shimotoriharuki/reRo_robotrace_board_public/README.md

# reRo_robotrace_board_public
This is the code and circuit for UnderBird_3.x.

The author of the schematic in the circuit directory is [IGC8810](https://github.com/IGC8810).

The author of the codes in the main_code directory and analysis_code directory is [Haruki SHIMOTORI](https://github.com/shimotoriharuki).

(https://www.youtube.com/watch?v=qso0mbpABHY)

# Environment
CubeIDE 1.11.2

# LICENSE
This repository is released under the BSD 3-Clause license.

© Haruki SHIMOTORI and IGC8810
