shimotoriharuki/reRo_robotrace_board_public/(threads)

Thread 1 (2025-08-12):

オープンソースライセンス誤用に関するお詫びと説明

X2002w, 2025-08-12:
i7 先輩

拝啓

個人開発者のXW2002（https://gitee.com/WL2002）と申します。まず、先輩が惜しみなく共有してくださった技術成果に心より感謝申し上げます。2023年に公開されたRoboTracer吸引式負圧に関する技術記事（https://underbirdworks.blogspot.com/2023/12/2023-underbird3x.html）は、私に多大な啓発と助けをくださいました。

このたび、私はGiteeにおいて自分が探求した吸引式負圧に関する技術経験のまとめを公開しましたが、その中で先輩のオープンソースコンテンツを参考にさせていただきました。しかし公開時に重大な過失を犯してしまいました。正しくはCC BY-SA 4.0を使用すべきところ、誤って別のライセンスを選択してしまったのです。

**問題に気付き次第、以下の是正措置を講じました。**

ライセンスをCC BY-SA 4.0に修正しました。
READMEファイルに先輩のオリジナルの貢献および技術記事のリンクを明記しました。
Giteeのコミット記録に今回の修正を特別に記載しました。

今回の失敗により先輩にご迷惑をおかけしたかもしれないこと、心よりお詫び申し上げます。先輩の技術共有は私にとって非常に大きな助けとなり、その上で私は吸引式負圧システムの開発をさらに進めることができました。また、この経験を通じて、オープンソース精神の尊さを深く実感しました。今回のオープンソースライセンスに関する不注意について、どうかご寛容いただけますようお願い申し上げます。もし他に修正や調整が必要な点がございましたら、どうぞご遠慮なくお知らせください。速やかに対応させていただきます。

shimotoriharuki, 2025-08-12:
Thank you for getting in touch. There is no problem. I appreciate your sincere response.
