shimotoriharuki/reRo_robotrace_board_public/main_code/Core/Src/main.c

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
/* Includes ------------------------------------------------------------------*/
#include "main.h"
#include "fatfs.h"

/* USER CODE BEGIN Includes */
//#include "AQM0802.h"
#include "stdio.h"
//#include "MPU6500.h"
#include "cppMain.hpp"

/* USER CODE END Includes */

ADC_HandleTypeDef hadc1;
DMA_HandleTypeDef hdma_adc1;

SD_HandleTypeDef hsd;
DMA_HandleTypeDef hdma_sdio_rx;
DMA_HandleTypeDef hdma_sdio_tx;

SPI_HandleTypeDef hspi2;
SPI_HandleTypeDef hspi3;

TIM_HandleTypeDef htim1;
TIM_HandleTypeDef htim2;
TIM_HandleTypeDef htim3;
TIM_HandleTypeDef htim4;
TIM_HandleTypeDef htim6;
TIM_HandleTypeDef htim7;
TIM_HandleTypeDef htim8;
TIM_HandleTypeDef htim10;

/* USER CODE BEGIN PV */
uint16_t tim6_timer;
uint16_t tim7_timer;
uint16_t tim10_timer;


/* USER CODE END PV */

void SystemClock_Config(void);
static void MX_GPIO_Init(void);
static void MX_DMA_Init(void);
static void MX_ADC1_Init(void);
static void MX_SDIO_SD_Init(void);
static void MX_SPI2_Init(void);
static void MX_TIM1_Init(void);
static void MX_TIM8_Init(void);
static void MX_TIM6_Init(void);
static void MX_TIM2_Init(void);
static void MX_TIM7_Init(void);
static void MX_SPI3_Init(void);
static void MX_TIM4_Init(void);
static void MX_TIM10_Init(void);
static void MX_TIM3_Init(void);
/* USER CODE BEGIN 0 */
int _write(int file, char *ptr, int len)
{
	int DataIdx;
	for(DataIdx=0; DataIdx<len; DataIdx++)
	{
		ITM_SendChar(*ptr++);
	}
	return len;
}


void HAL_GPIO_EXTI_Callback(uint16_t GPIO_Pin)
{
	cppExit(GPIO_Pin);
}


void HAL_TIM_PeriodElapsedCallback(TIM_HandleTypeDef *htim)
{
	if(htim->Instance == TIM7){		//0.1ms
		cppFlip100ns();

		tim7_timer++;
		if(tim7_timer >= 100000) tim7_timer = 0;
	}

	if (htim->Instance == TIM6){	//1msec
		cppFlip1ms();

		tim6_timer++;
		if(tim6_timer >= 100000) tim6_timer = 0;
	}

	if (htim->Instance == TIM10){	//10msec
		cppFlip10ms();

		tim10_timer++;
		if(tim10_timer >= 100000) tim10_timer = 0;
	}

}

/* USER CODE END 0 */

/**
  * @brief  The application entry point.
  * @retval int
  */
int main(void)
{
  /* MCU Configuration--------------------------------------------------------*/

  /* Reset of all peripherals, Initializes the Flash interface and the Systick. */
  HAL_Init();

  /* Configure the system clock */
  SystemClock_Config();

  /* Initialize all configured peripherals */
  MX_GPIO_Init();
  MX_DMA_Init();
  MX_ADC1_Init();
  MX_SDIO_SD_Init();
  MX_SPI2_Init();
  MX_TIM1_Init();
  MX_TIM8_Init();
  MX_TIM6_Init();
  MX_FATFS_Init();
  MX_TIM2_Init();
  MX_TIM7_Init();
  MX_SPI3_Init();
  MX_TIM4_Init();
  MX_TIM10_Init();
  MX_TIM3_Init();
  /* USER CODE BEGIN 2 */
	cppInit();


	//printf("HelloWorld!!\r\n");


  /* USER CODE END 2 */

  /* Infinite loop */
  /* USER CODE BEGIN WHILE */
	while (1)
	{
		cppLoop();

    /* USER CODE END WHILE */

    /* USER CODE BEGIN 3 */
	}
  /* USER CODE END 3 */
}

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
