shimotoriharuki/reRo_robotrace_board_public/main_code/reRo_robotrace_board_code.ioc

Mcu.UserName=STM32F446RETx
PA0-WKUP.Signal=ADCx_IN0
PA1.Signal=ADCx_IN1
PA10.Signal=S_TIM1_CH3
PA11.Signal=S_TIM1_CH4
PA12.Signal=GPIO_Input
PA13.Signal=SYS_JTMS-SWDIO
PA14.Signal=SYS_JTCK-SWCLK
PA15.Signal=GPIO_Output
PA2.Signal=ADCx_IN2
PA3.Signal=ADCx_IN3
PA4.Signal=ADCx_IN4
PA5.Signal=ADCx_IN5
PA6.Signal=ADCx_IN6
PA7.Signal=ADCx_IN7
PA8.Signal=S_TIM1_CH1
PA9.Signal=S_TIM1_CH2
PB0.Signal=S_TIM3_CH3
PB1.Signal=S_TIM3_CH4
PB12.Signal=GPIO_Output
PB13.Signal=SPI2_SCK
PB14.Signal=SPI2_MISO
PB15.Signal=SPI2_MOSI
PB3.Signal=SYS_JTDO-SWO
PB4.Signal=GPIO_Output
PB5.Signal=SPI3_MOSI
PB6.Signal=S_TIM4_CH1
PB7.Signal=S_TIM4_CH2
PB8.Signal=S_TIM2_CH1_ETR
PB9.Signal=S_TIM2_CH2
PC0.Signal=ADCx_IN10
PC1.Signal=ADCx_IN11
PC10.Signal=SPI3_SCK
PC11.Signal=GPIO_Input
PC12.Signal=SDIO_CK
PC13.Signal=GPXTI13
PC14-OSC32_IN.Signal=GPXTI14
PC15-OSC32_OUT.Signal=GPIO_Output
PC2.Signal=ADCx_IN12
PC3.Signal=ADCx_IN13
PC4.Signal=ADCx_IN14
PC5.Signal=GPIO_Output
PC6.Signal=S_TIM8_CH1
PC7.Signal=S_TIM8_CH2
PC8.Signal=SDIO_D0
PC9.Signal=GPIO_Input
PD2.Signal=SDIO_CMD
PH0-OSC_IN.Signal=RCC_OSC_IN
PH1-OSC_OUT.Signal=RCC_OSC_OUT
