shimotoriharuki/reRo_robotrace_board_public/main_code/Core/Src/sdCard.cpp

/*
 * sdCard.cpp
 *
 *  Created on: Jun 22, 2023
 *      Author: SHIMOTORI Haruki
 */

#include "sdCard.hpp"
#include "AQM0802.h"
#include <stdio.h>
#include "string.h"
#include <iostream>

void sdCard::openFile(const char *p_directory_name, const char *p_file_name)
{
	static int num;
	sprintf(dirpath_, "%s", p_directory_name);
	sprintf(filepath_, "%s", p_file_name);
	num++;

	f_mkdir(dirpath_);
	f_chdir(dirpath_);
	f_open(&fil_, filepath_, FA_OPEN_EXISTING| FA_READ | FA_WRITE);
	f_chdir("..");
}

void sdCard::clearBuff()
{
	for(int i = 0; i < BUFF_SIZE; i++){
		buffer_[i] = '\0';
	}
}

sdCard::sdCard() : buffer_{0}, filepath_{0}, dirpath_{0}{}

bool sdCard::init()
{
	if(mount() == 1){
		return true;

	}
	else{
		return false;
	}

}


bool sdCard::mount()
{
	bool ret = false;

	if(f_mount(&fs_, "", 1) == FR_OK) ret = true;
	else ret = false;

	return ret;
}

bool sdCard::unmout()
{
	bool ret = false;

	if(f_mount(NULL, "", 1) == FR_OK) ret = true;
	else ret = false;

	return ret;

}
void sdCard::userFopen(const char *p_directory_name, const char *p_file_name)
{
	openFile(p_directory_name, p_file_name);
}
void sdCard::userFclose()
{
	f_close(&fil_);	//ファイル閉じる
}
void sdCard::write(const char *p_directory_name, const char *p_file_name, uint16_t size, float *data)
{
	FRESULT res;

	// Change directory
	sprintf(dirpath_, "%s", p_directory_name);
	f_mkdir(dirpath_);
	f_chdir(dirpath_);

	// Initialize hidden file path for the serial number of filename
	char hidden_file_path[32];
	sprintf(hidden_file_path, "%c%s", '.', p_file_name);
	res = f_open(&fil_, hidden_file_path, FA_CREATE_NEW | FA_READ | FA_WRITE);
	if(res != FR_EXIST){ // If there is not the hidden file
		snprintf(buffer_, BUFF_SIZE, "%d", 0);
		f_lseek(&fil_, f_size(&fil_));	//	ファイルの最後に移動
		f_write(&fil_, buffer_, strlen(buffer_), &bw_);	//	書き込む
		f_close(&fil_);	//	ファイル閉じる

		f_chmod(hidden_file_path, AM_HID, AM_HID); // Set as hidden file

		clearBuff();	//	書き込み用のバッファをクリア
	}

	// ------Create file path----------//
	// Copy file name
	char file_name[32] = {'\0'};
	sprintf(file_name, "%s", p_file_name);

	// Get serial number
	char char_number[5] = {'\0'};
	res = f_open(&fil_, hidden_file_path, FA_OPEN_ALWAYS | FA_READ | FA_WRITE);
	f_gets(char_number, sizeof(char_number), &fil_);
	f_close(&fil_);	//	ファイル閉じる

	// Linkng
	char extension[5] = {'.', 't', 'x', 't', '\0'};
	sprintf(filepath_, "%s%s%s", file_name, char_number, extension);


	int int_number = 0;
	sscanf(char_number, "%d", &int_number);

	res = f_open(&fil_, filepath_, FA_CREATE_NEW | FA_READ | FA_WRITE);
	//if(res == FR_EXIST){ // If there is same file
	while(res == FR_EXIST){ // While there is same file
		int_number++;
		if(int_number >= 99999) int_number = 99999;

		sprintf(char_number, "%d", int_number);
		sprintf(filepath_, "%s%s%s", file_name, char_number, extension);
		res = f_open(&fil_, filepath_, FA_CREATE_NEW | FA_READ | FA_WRITE);
	}
	for(short i = 0 ; i < size; i++){
		snprintf(buffer_, BUFF_SIZE, "%f\n", *(data + i));	//floatをstringに変換

		f_lseek(&fil_, f_size(&fil_));	//	ファイルの最後に移動
		f_write(&fil_, buffer_, strlen(buffer_), &bw_);	//	書き込む

		clearBuff();	//	書き込み用のバッファをクリア
	}
	f_close(&fil_);	//	ファイル閉じる

	res = f_open(&fil_, hidden_file_path, FA_OPEN_ALWAYS | FA_READ | FA_WRITE);
	int_number++;
	if(int_number >= 99999) int_number = 99999;
	sprintf(char_number, "%d", int_number);
	f_lseek(&fil_, 0);
	f_write(&fil_, char_number, strlen(char_number), &bw_);	//	書き込む
	f_close(&fil_);	//	ファイル閉じる

	f_chdir("..");

}

void sdCard::read(const char *p_directory_name, const char *p_file_name, uint16_t size, float *data)
{
	short i = 0;

	openFile(p_directory_name, p_file_name);

	while(f_gets(buffer_, sizeof(buffer_), &fil_) != NULL){
		sscanf(buffer_, "%f", data + i);
		i++;
		if(i >= size) i = size - 1;

	}

	clearBuff();

	f_close(&fil_);

}
