shimotoriharuki/reRo_robotrace_board_public/main_code/Core/Inc/AQM0802.h

/*
 * AQM0802.h
 *
 *  Created on: 2023/05/14
 *      Author: iguchi
 */

#ifndef SRC_LCD_AQM0802_H_
#define SRC_LCD_AQM0802_H_

#include "main.h"
#include <stdio.h>
#include <stdarg.h>

//extern I2C_HandleTypeDef hi2c1;

void lcd_cmd(uint8_t);
void lcd_data(uint8_t);
void lcd_init(void);
void lcd_clear(void);
void lcd_locate(int,int);
void lcd_print(const char *);
short lcd_printf(const char *, ...);

#endif /* SRC_LCD_AQM0802_H_ */
