shimotoriharuki/reRo_robotrace_board_public/(commit log)

2023-12-17 回路図追加
2023-12-17 README更新
2023-12-17 いらないファイル削除
