shimotoriharuki/reRo_robotrace_board_public/(notices)

Notices in the files:
main_code/Core/Src/main.c:
Copyright (c) 2023 STMicroelectronics.
All rights reserved.
This software is licensed under terms that can be found in the LICENSE file
